joshuata/impresence-esphome/docs/datasheets/README.md

# Datasheets

The design follows these third-party datasheets, drawings and 3D models. They belong to their manufacturers and are **not committed**: every subfolder here is git-ignored. Download each file from the URL below into the listed path, then check its SHA-256 to confirm you have the same revision the design was based on.

## HLK-LD2460 (Hi-Link)

Source: [Hi-Link product page](https://www.hlktech.net/index.php?id=1335)

| Document | Local path | SHA-256 |
|---|---|---|
| 2T4R Multi Target Trajectory Tracking Module Manual V1.1 | `ld2460/HLK-LD2460 2T4R Multi Target Trajectory Tracking Module Manual V1.1.pdf` | `1f7e0840185f4ef637c43628fb0fc450aaa14f3ec1358664a33fe51ff7acb751` |
| Serial port communication protocol V1.0 | `ld2460/HLK-LD2460 Serial port communication protocol V1.0.pdf` | `9379670505e44ac23212f48aa4ea569a456dd357da94abdaace0f80ddd47cfaa` |

## Seeed Studio XIAO ESP32-S3

Source: [Seeed wiki, Resources section](https://wiki.seeedstudio.com/xiao_esp32s3_getting_started/)

| Document | Local path | URL | SHA-256 |
|---|---|-----|---|
| Schematic v1.4 | `xiao-esp32s3/XIAO ESP32S3 v1.4 SCH.pdf` | [files.seeedstudio.com](https://files.seeedstudio.com/wiki/SeeedStudio-XIAO-ESP32S3/new-res/202003751_XIAO%20ESP32S3_v1.4_SCH_260226.pdf.pdf) | `15993097cd695d177af352f4664ca91290a99c833f51d122d1165ef222f9923c` |
| Dimension drawing v1.1 (DXF) | `xiao-esp32s3/XIAO_ESP32S3_v1.1_Dimensioning.dxf` | [files.seeedstudio.com](https://files.seeedstudio.com/wiki/SeeedStudio-XIAO-ESP32S3/res/XIAO_ESP32S3_v1.1_Dimensioning.dxf) | `5fd32e3ba7a4bd85b8cc0f5d9413e26dd947e84e27b2d0f03350a7d367903f23` |
| 3D model (STEP in zip) | `xiao-esp32s3/seeed-studio-xiao-esp32s3-3d_model.zip` | [files.seeedstudio.com](https://files.seeedstudio.com/wiki/SeeedStudio-XIAO-ESP32S3/res/seeed-studio-xiao-esp32s3-3d_model.zip) | `0d552ed2cc7359ea132601f4f7fe2c9d816e2dfe4f58f6463e83f84a901d3650` |
| ESP32-S3 Series Datasheet v2.2 (Espressif) | `xiao-esp32s3/esp32-s3_datasheet_en.pdf` | [espressif.com](https://www.espressif.com/sites/default/files/documentation/esp32-s3_datasheet_en.pdf) | `2d5a7cb7fd559d8d972bd88db32669c0196d23f22d7afaafb0f63d099b589a3f` |

## Sensirion SCD41

| Document | Local path | URL | SHA-256 |
|---|---|-----|---|
| SCD4x Datasheet, Version 1.5 (July 2023) | `scd41/Sensirion_SCD4x_Datasheet.pdf` | [sensirion.com](https://sensirion.com/media/documents/48C4B7FB/64C134E7/Sensirion_SCD4x_Datasheet.pdf) | `618d5222e3b07dd0d157f171bf846dc3f76512139f46cbdf0248aac71dc9cb93` |

## Vishay VEML7700

| Document | Local path | URL | SHA-256 |
|---|---|-----|---|
| VEML7700 Datasheet, Rev. 1.8 (28-Nov-2024), doc. 84286 | `veml7700/veml7700.pdf` | [vishay.com](https://www.vishay.com/docs/84286/veml7700.pdf) | `f338cf7d5911828a2f2ac8ae8324049380c852e34aa5afa43ac92c98ffe827d1` |

## Seeed Studio XIAO ESP32-C6 (compatibility checks only)

Source: [Seeed wiki](https://wiki.seeedstudio.com/xiao_esp32c6_getting_started/)

| Document | Local path | URL | SHA-256 |
|---|---|-----|---|
| Schematic v1.0 | `xiao-esp32c6/XIAO_ESP32_C6_v1.0_SCH.pdf` | [files.seeedstudio.com](https://files.seeedstudio.com/wiki/SeeedStudio-XIAO-ESP32C6/XIAO_ESP32_C6_v1.0_SCH_260114.pdf) | `510f3f917bcded1201ca5c63374409183457c1ef83a836988517d6802180dad7` |

## Adafruit SCD-40 breakout (product 5187)

Source: [Adafruit learn guide, Downloads](https://learn.adafruit.com/adafruit-scd-40-and-scd-41/downloads). The 3D model is from [Adafruit_CAD_Parts](https://github.com/adafruit/Adafruit_CAD_Parts/tree/main/5187%20SCD-40%20C02%20Sensor) (MIT licence).

| Document | Local path | URL | SHA-256 |
|---|---|-----|---|
| Fab print | `adafruit-scd40/adafruit_products_SCD4x_fab_print.png` | [cdn-learn.adafruit.com](https://cdn-learn.adafruit.com/assets/assets/000/104/049/large1024/adafruit_products_SCD4x_fab_print.png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) | `f7c8b4336b451d4d6fa2e69dc30ba917c10d474534520323be57a2c2aae8b033` |
| Schematic (rev B) | `adafruit-scd40/adafruit_products_SCD4x_sch.png` | [cdn-learn.adafruit.com](https://cdn-learn.adafruit.com/assets/assets/000/104/048/large1024/adafruit_products_SCD4x_sch.png?1629921323) | `5f078635e144877840dd97402148c2d985294ef221f5ae5ef69c5b90ea77f613` |
| Learn guide PDF | `adafruit-scd40/adafruit-scd-40-and-scd-41.pdf` | [cdn-learn.adafruit.com](https://cdn-learn.adafruit.com/downloads/pdf/adafruit-scd-40-and-scd-41.pdf) | `d373d1c9c4581c433715a474e67f55e965fe1a0929d92f5881b48278a582eb13` |
| 3D model (STEP) | `adafruit-scd40/5187 SCD-40 C02 Sensor.step` | [raw.githubusercontent.com](https://raw.githubusercontent.com/adafruit/Adafruit_CAD_Parts/main/5187%20SCD-40%20C02%20Sensor/5187%20SCD-40%20C02%20Sensor.step) | `9ecbba315ab20394f68605f10ba91036032e32a3442c19d9b6fca4d0715aa476` |

## Adafruit VEML7700 Lux Sensor, STEMMA QT (product 5378)

Source: [Adafruit learn guide, Downloads](https://learn.adafruit.com/adafruit-veml7700/downloads). The 3D model is from [Adafruit_CAD_Parts](https://github.com/adafruit/Adafruit_CAD_Parts/tree/main/5378%20VEML7700%20Lux%20Sensor) (MIT licence).

| Document | Local path | URL | SHA-256 |
|---|---|-----|---|
| Fab print (STEMMA QT version) | `adafruit-veml7700/adafruit_products_VEML7700Q_fab_print.png` | [cdn-learn.adafruit.com](https://cdn-learn.adafruit.com/assets/assets/000/108/947/large1024/adafruit_products_VEML7700Q_fab_print.png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) | `bba3a123cd8106b282c502b9e98997bf3f3443f6b6914d9a1f84e126789fbf1d` |
| Schematic (rev B) | `adafruit-veml7700/adafruit_products_VEML7700Q_sch.png` | [cdn-learn.adafruit.com](https://cdn-learn.adafruit.com/assets/assets/000/108/946/large1024/adafruit_products_VEML7700Q_sch.png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) | `af536e9636d616e41c703b6d377702561ced9c80ae9c34e656a88e1900e13278` |
| Learn guide PDF | `adafruit-veml7700/adafruit-veml7700.pdf` | [cdn-learn.adafruit.com](https://cdn-learn.adafruit.com/downloads/pdf/adafruit-veml7700.pdf) | `9b45c3a83fa7c2229fde7b10b9ba15b2ee7f33fc30a32cc4bc624e1b0289b8d3` |
| 3D model (STEP) | `adafruit-veml7700/5378 VEML7700 Lux Sensor.step` | [raw.githubusercontent.com](https://raw.githubusercontent.com/adafruit/Adafruit_CAD_Parts/main/5378%20VEML7700%20Lux%20Sensor/5378%20VEML7700%20Lux%20Sensor.step) | `12a7e29cb047af4122055bfc5efd37159e195403dc17dcd5e27abfefc21e12b7` |
