joshuata/impresence-esphome/hardware/pcb/presence-pcb-bom-jlcpcb.csv

Comment | Designator | Footprint | LCSC Part #
22uF | C1,C5 | C_0805_2012Metric | C45783
100nF | C2 | C_0805_2012Metric | C49678
10uF | C3,C4 | C_0805_2012Metric | C15850
SS34 | D1 | D_SMA | C8678
BLM21PG221SN1D | FB1 | L_0805_2012Metric | C85840
LD2460 J1 socket 2x4 2.0mm | J1 | LD2460_J1_Socket_2x04_P2.00mm | C2906072
LD2460 JP103 socket 2x2 2.0mm | J2 | LD2460_JP103_Socket_2x02_P2.00mm | C2906070
Qwiic (JST SH BM04B-SRSS-TB, vertical) | J3 | JST_SH_BM04B-SRSS-TB_1x04-1MP_P1.00mm_Vertical | C160390
AP2112K-3.3 | U2 | SOT-23-5 | C51118
