joshuata/impresence-esphome/hardware/pcb/presence-pcb-bom.csv

Designator | Value | Footprint | MPN | Manufacturer | LCSC Part # | Qty | DNP
C1,C5 | 22uF | Capacitor_SMD:C_0805_2012Metric | CL21A226MAQNNNE | Samsung | C45783 | 2
C2 | 100nF | Capacitor_SMD:C_0805_2012Metric | CC0805KRX7R9BB104 | Yageo | C49678 | 1
C3,C4 | 10uF | Capacitor_SMD:C_0805_2012Metric | CL21A106KAYNNNE | Samsung | C15850 | 2
D1 | SS34 | Diode_SMD:D_SMA | SS34 | MDD | C8678 | 1
FB1 | BLM21PG221SN1D | Inductor_SMD:L_0805_2012Metric | BLM21PG221SN1D | Murata | C85840 | 1
J1 | LD2460 J1 socket 2x4 2.0mm | presence:LD2460_J1_Socket_2x04_P2.00mm | PM200-2-04-Z-4.3 | HCTL | C2906072 | 1
J2 | LD2460 JP103 socket 2x2 2.0mm | presence:LD2460_JP103_Socket_2x02_P2.00mm | PM200-2-02-Z-4.3 | HCTL | C2906070 | 1
J3 | Qwiic (JST SH BM04B-SRSS-TB, vertical) | Connector_JST:JST_SH_BM04B-SRSS-TB_1x04-1MP_P1.00mm_Vertical | BM04B-SRSS-TB(LF)(SN) | JST | C160390 | 1
J4 | Qwiic alt 1x4 2.54mm | Connector_PinHeader_2.54mm:PinHeader_1x04_P2.54mm_Vertical | 1x4 2.54 mm pin header |  |  | 1 | DNP
J5 | 5V in (hardwired) | Connector_PinHeader_2.54mm:PinHeader_1x02_P2.54mm_Vertical | 1x2 2.54 mm pin header or 2-pin 2.54 mm screw terminal |  |  | 1 | DNP
R1,R2 | 4.7k | Resistor_SMD:R_0805_2012Metric | 0805W8F4701T5E | UNI-ROYAL | C17673 | 2 | DNP
U1 | Seeed XIAO ESP32-S3 | presence:XIAO_ESP32S3_EdgePins | XIAO ESP32S3 | Seeed Studio |  | 1
U2 | AP2112K-3.3 | Package_TO_SOT_SMD:SOT-23-5 | AP2112K-3.3TRG1 | Diodes Inc. | C51118 | 1
