joshuata/impresence-esphome/(list of files, cad)

Other CAD files:
hardware/fusion/adafruit-scd40.f3d
hardware/fusion/adafruit-veml7700.f3d
hardware/fusion/ld2460 Board.f3d
hardware/fusion/presence-skeleton.f3d
hardware/fusion/xiao-esp32s3.f3d
