joshuata/impresence-esphome/hardware/kicad/presence-pcb.kicad_pcb

## KiCad design hardware/kicad/presence-pcb.kicad_pcb (2026-11-06)

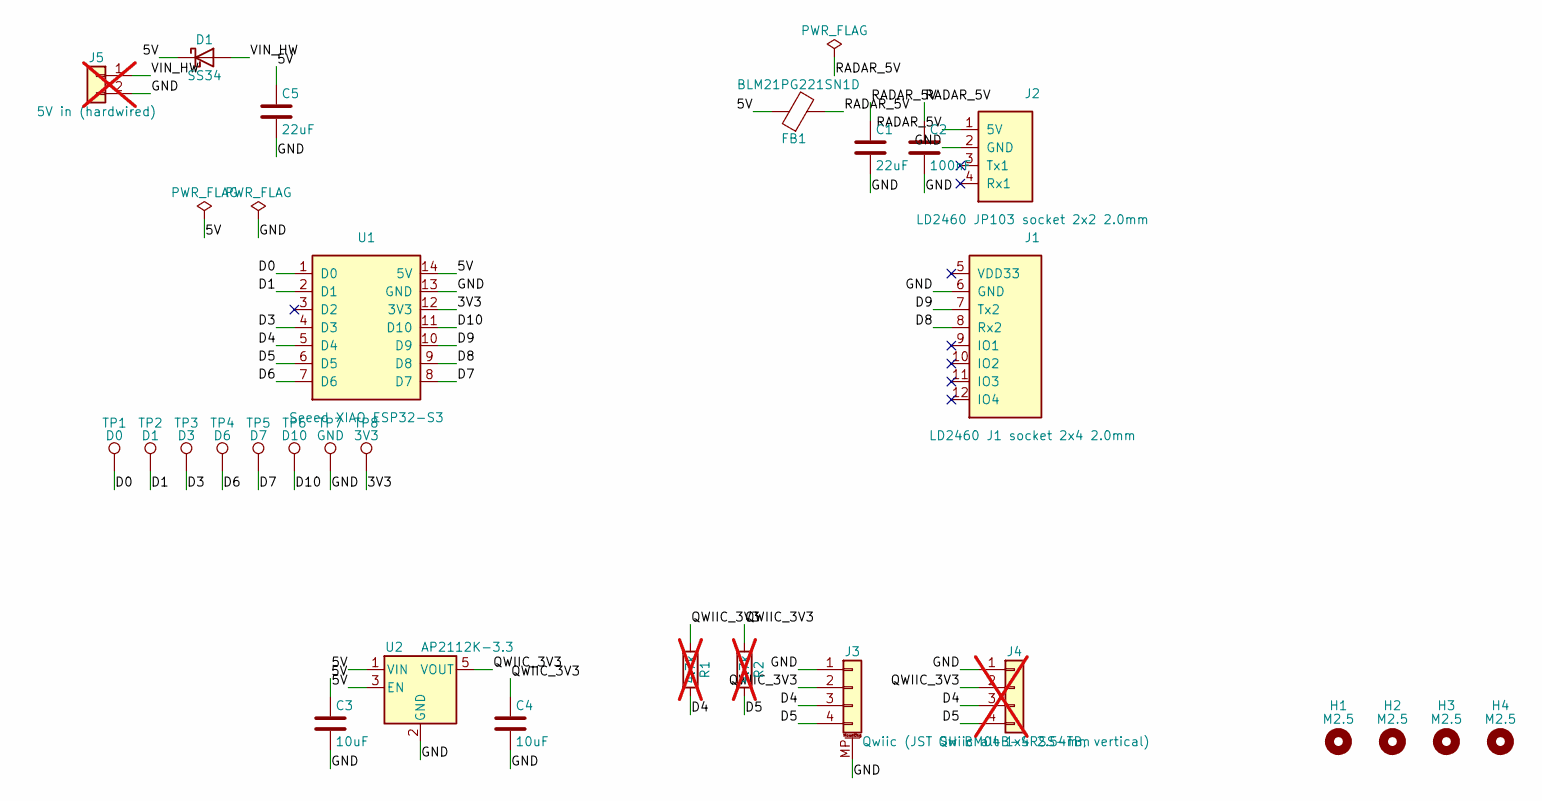
[picture p1: schematic presence-pcb.kicad_sch]

Parts:
C1, C5: 22uF; C_0805_2012Metric; MPN CL21A226MAQNNNE; LCSC C45783
C2: 100nF; C_0805_2012Metric; MPN CC0805KRX7R9BB104; LCSC C49678
C3, C4: 10uF; C_0805_2012Metric; MPN CL21A106KAYNNNE; LCSC C15850
D1: SS34; D_SMA; MPN SS34; LCSC C8678
FB1: BLM21PG221SN1D; L_0805_2012Metric; MPN BLM21PG221SN1D; LCSC C85840
H1, H2, H3, H4: M2.5; MountingHole_2.7mm_M2.5
J1: LD2460 J1 socket 2x4 2.0mm; LD2460_J1_Socket_2x04_P2.00mm; MPN PM200-2-04-Z-4.3; LCSC C2906072
J2: LD2460 JP103 socket 2x2 2.0mm; LD2460_JP103_Socket_2x02_P2.00mm; MPN PM200-2-02-Z-4.3; LCSC C2906070
J3: Qwiic (JST SH BM04B-SRSS-TB, vertical); JST_SH_BM04B-SRSS-TB_1x04-1MP_P1.00mm_Vertical; MPN BM04B-SRSS-TB(LF)(SN); LCSC C160390
J4: Qwiic alt 1x4 2.54mm; PinHeader_1x04_P2.54mm_Vertical; MPN 1x4 2.54 mm pin header; not fitted
J5: 5V in (hardwired); PinHeader_1x02_P2.54mm_Vertical; MPN 1x2 2.54 mm pin header or 2-pin 2.54 mm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; not fitted
R1, R2: 4.7k; R_0805_2012Metric; MPN 0805W8F4701T5E; LCSC C17673; not fitted
TP1: D0; TestPoint_THTPad_D1.5mm_Drill0.7mm
TP2: D1; TestPoint_THTPad_D1.5mm_Drill0.7mm
TP3: D3; TestPoint_THTPad_D1.5mm_Drill0.7mm
TP4: D6; TestPoint_THTPad_D1.5mm_Drill0.7mm
TP5: D7; TestPoint_THTPad_D1.5mm_Drill0.7mm
TP6: D10; TestPoint_THTPad_D1.5mm_Drill0.7mm
TP7: GND; TestPoint_THTPad_D1.5mm_Drill0.7mm
TP8: 3V3; TestPoint_THTPad_D1.5mm_Drill0.7mm
U1: Seeed XIAO ESP32-S3; XIAO_ESP32S3_EdgePins; MPN XIAO ESP32S3
U2: AP2112K-3.3; SOT-23-5; MPN AP2112K-3.3TRG1; LCSC C51118

Connections:
/3V3: TP8.1, U1.12 (3V3)
/5V: C3.1, C5.1, D1.1 (K), FB1.1, U1.14 (5V), U2.1 (VIN), U2.3 (EN)
/D0: TP1.1, U1.1 (D0)
/D1: TP2.1, U1.2 (D1)
/D3: TP3.1, U1.4 (D3)
/D4: J3.3, J4.3, R1.2, U1.5 (D4)
/D5: J3.4, J4.4, R2.2, U1.6 (D5)
/D6: TP4.1, U1.7 (D6)
/D7: TP5.1, U1.8 (D7)
/D8: J1.8 (Rx2), U1.9 (D8)
/D9: J1.7 (Tx2), U1.10 (D9)
/D10: TP6.1, U1.11 (D10)
/GND: C1.2, C2.2, C3.2, C4.2, C5.2, J1.6 (GND), J2.2 (GND), J3.1, J3.MP (MountPin), J4.1, J5.2, TP7.1, U1.13 (GND), U2.2 (GND)
/QWIIC_3V3: C4.1, J3.2, J4.2, R1.1, R2.1, U2.5 (VOUT)
/RADAR_5V: C1.1, C2.1, FB1.2, J2.1 (5V)
/VIN_HW: D1.2 (A), J5.1

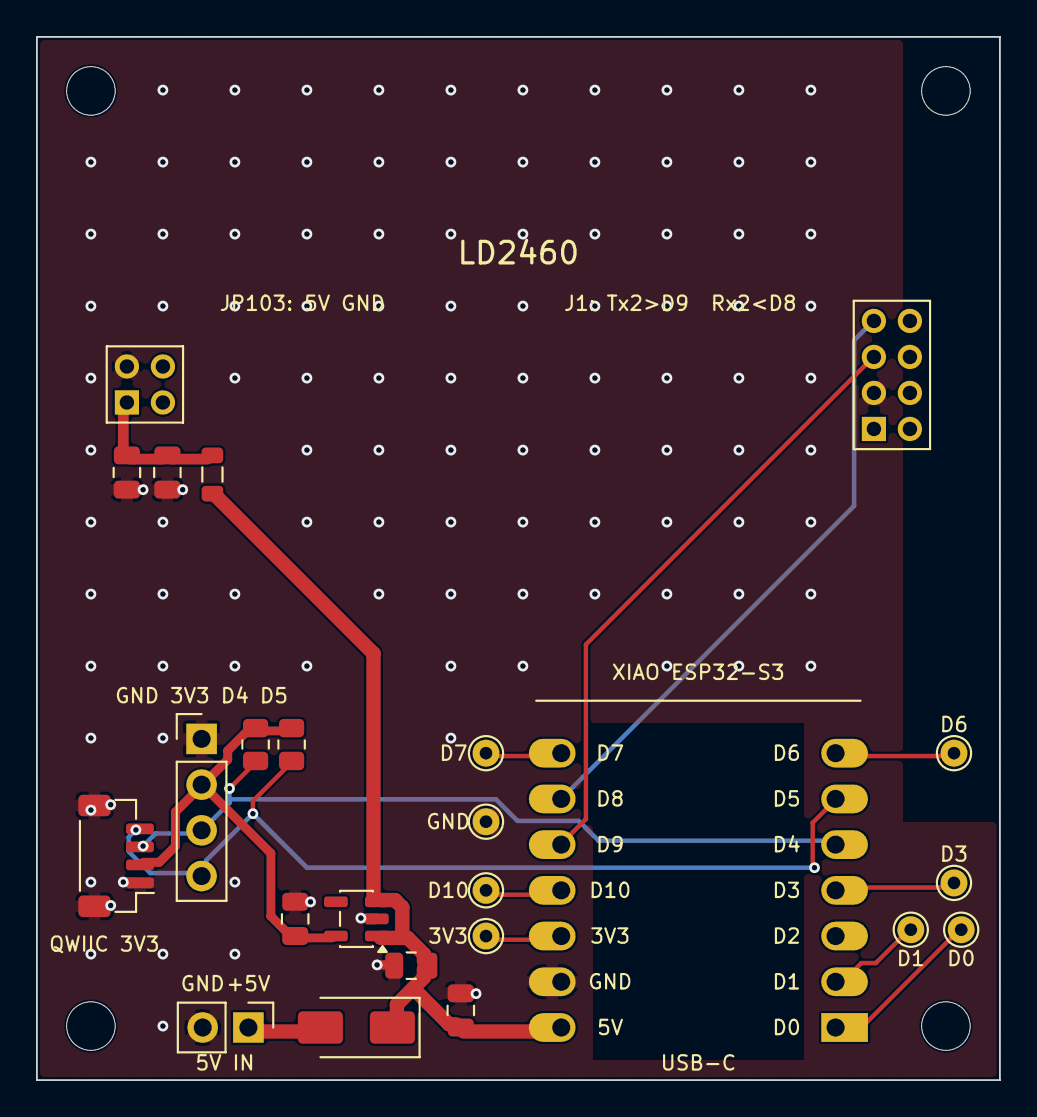
[picture p2: board presence-pcb.kicad_pcb from above]

Board: 2 copper layers, 53.5 x 58.0 mm, 28 parts (0 on the bottom side), 16 nets.
