joshuata/impresence-esphome/(commit log)

2026-11-06 Set up Git LFS and local-only datasheets
    Track Fusion archives, 3MF/STEP/STL and PCB Gerber zips with Git LFS.
    Keep third-party datasheets, drawings and models under docs/datasheets/
    out of git, and add poppler to mise for reading PDFs.
2026-11-06 Document project scope, parts and agent workflow
    AGENTS.md: XIAO ESP32-S3 target with C6 compatibility rules, native
    ld2460 component, Qwiic breakouts (Adafruit SCD-40, VEML7700), plans in
    .agents/plans, datasheet handling, and Fusion source/fabrication export
    rules. README: scaffold with parts list. docs/datasheets/README.md: sources
    and SHA-256 for every reference document.
2026-11-06 Add XIAO ESP32-S3 board package
    Pin substitutions for the I2C bus (D4/D5) and LD2460 UART (D8/D9),
    chosen to avoid S3 strapping pins and UART0 boot output and to stay
    compatible with the XIAO ESP32-C6. Validated with esphome config.
2026-11-06 Add PCB and enclosure layout plan
    Decisions, LD2460 reference data, pin assignment, power, mount interface
    and wedge, breakout mounting, and remaining steps.
2026-11-06 Export parametric component models from Fusion
    Fusion archives exported from the "Presence sensor" project:
    ld2460 Board (v3), xiao-esp32s3 (v1), adafruit-scd40 (v1),
    adafruit-veml7700 (v1). All sketches fully constrained and driven by
    named user parameters.
    [adafruit-scd40.f3d, adafruit-veml7700.f3d, ld2460 Board.f3d, xiao-esp32s3.f3d]
2026-11-06 Add presence-skeleton and expose component parameters
    presence-skeleton derives the LD2460 and XIAO models (favourite
    parameters come in as *_Ref) and places them with parametric moves:
    radar long edge horizontal with JP103 on the viewer's left (ESPHome
    side-mount axes), XIAO below and offset right with USB-C down. Holds
    all case, PCB, insert, mount, hinge, antenna and USB parameters; case
    depth is derived so the side-wall antenna always fits. Layout front,
    section and antenna-zone sketches are fully constrained and flex-tested.
    ld2460 Board (v4) and xiao-esp32s3 (v2) re-exported with their user
    parameters marked as favourites.
    [ld2460 Board.f3d, presence-skeleton.f3d, xiao-esp32s3.f3d]
2026-11-06 Document skeleton parameters in hardware/README.md
    Table of every presence-skeleton user parameter with its current value,
    plus AGENTS.md rules for keeping it updated, deriving component
    parameters, and when Fusion exports .f3d vs .f3z.
2026-11-06 Add initial-prototype roadmap plan
    Stages the work as radar + PCB first in a book-style case with the
    XIAO antenna and heat-set inserts; marks the earlier layout plan as
    reference.
2026-11-06 Add main PCB v1 (KiCad): schematic, board and fab outputs
    Step 4 of the initial-prototype roadmap, designed in KiCad 10 instead of
    Fusion Electronics. Outline, M2.5 holes, radar sockets and XIAO position
    come from presence-skeleton (read only; no skeleton changes).
    - XIAO ESP32-S3 on the 14 edge pins; nets named after XIAO pins and
    matching firmware/boards/xiao-esp32s3.yaml (D8/D9 radar UART, D4/D5 I2C)
    - LD2460 J1/JP103 2.0 mm sockets, pin numbers from manual V1.1 Fig. 3
    - Radar 5 V filter (ferrite bead + 22 uF + 100 nF)
    - Qwiic JST-SH + 1x4 2.54 mm pads on a dedicated AP2112K-3.3 LDO,
    DNP I2C pull-ups, through-hole test pads for spare pins
    - Optional hardwired 5 V input through an SS3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
    [presence-pcb-bom-jlcpcb.csv, presence-pcb-bom.csv, presence-pcb.kicad_pcb, presence-pcb.kicad_sch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]
2026-11-06 PCB: switch the Qwiic socket J3 to top entry (BM04B-SRSS-TB)
    User request: a vertical Qwiic plug instead of the side-entry SM04B.
    J3 is now a JST BM04B-SRSS-TB (LCSC C160390). The body centre is at
    (-22.8, -27.5), 3.45 mm in from the left PCB edge and clear of the
    cover lip. Re-routed; ERC, DRC and schematic parity clean. Fab outputs
    regenerated 2026-11-06.
    [presence-pcb-bom-jlcpcb.csv, presence-pcb-bom.csv, presence-pcb.kicad_pcb, presence-pcb.kicad_sch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]
